KombinatAeppaeraet/mute-macbook-microphone-in-style/assets/usb-cable.jpg

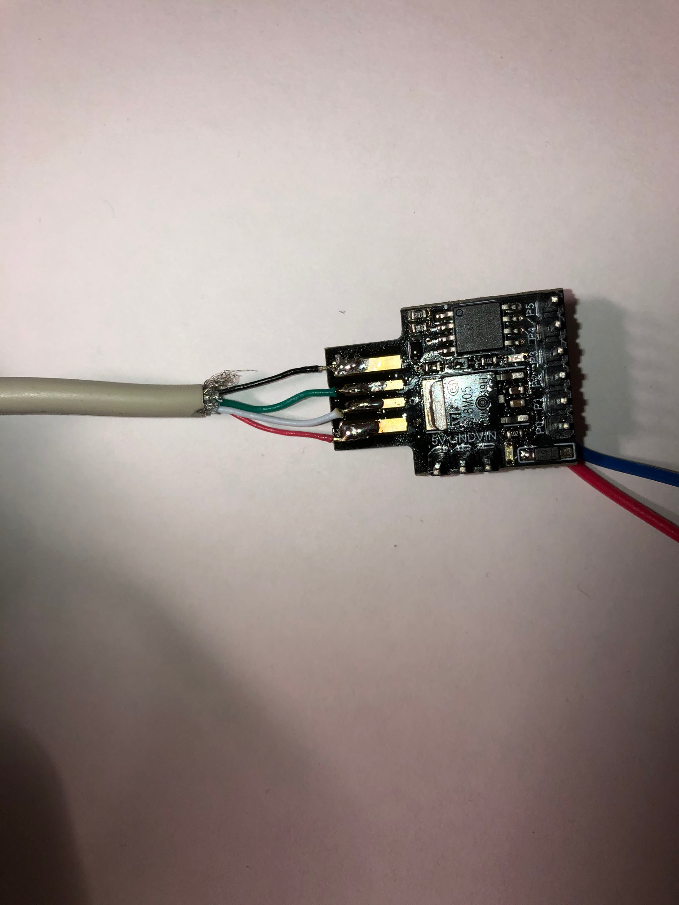
assets/usb-cable.jpg
